GoncaloR00/FireCopter/(commit log)

2022-04-19 Adicionei ficheiros para testar ssh
2022-04-26 Metodologia para programar a raspberry
2022-05-02 Class para a Picamera feita e testada
2022-05-02 Preparação para conectar o controlo remotamente
2022-06-13 Limpei tudo para posterior atualização
2022-06-13 Organizei o computador de voo
2022-06-25 Carreguei para backup, organizarei após alguns testes
2022-06-25 Problemas com mensagens TYPR resolvidos e velocidade melhorada
2022-06-25 Comunicações TCP e serial corrigidas
    [serial_communication.py]
2022-06-26 Adicionei comandos ao controlador de voo
2022-06-28 Adicionei uma pausa até que haja comunicação serial
2022-06-30 Algumas alterações e adição da parte da camera
2022-07-01 Camera na interface
2022-07-01 hsv e camera terminados
2022-07-01 correção de ip
